Jayavsingh30/Rubiks-Cube-Solving-Robot-/README.md

https://github.com/user-attachments/assets/8eff1edc-73fc-4dad-ae04-fb5bdb494c74
