Jayavsingh30/Rubiks-Cube-Solving-Robot-/Hardware/pcb/arduino_nano/abc.kicad_pcb

## KiCad design Hardware/pcb/arduino_nano/abc.kicad_pcb (2025-05-24)

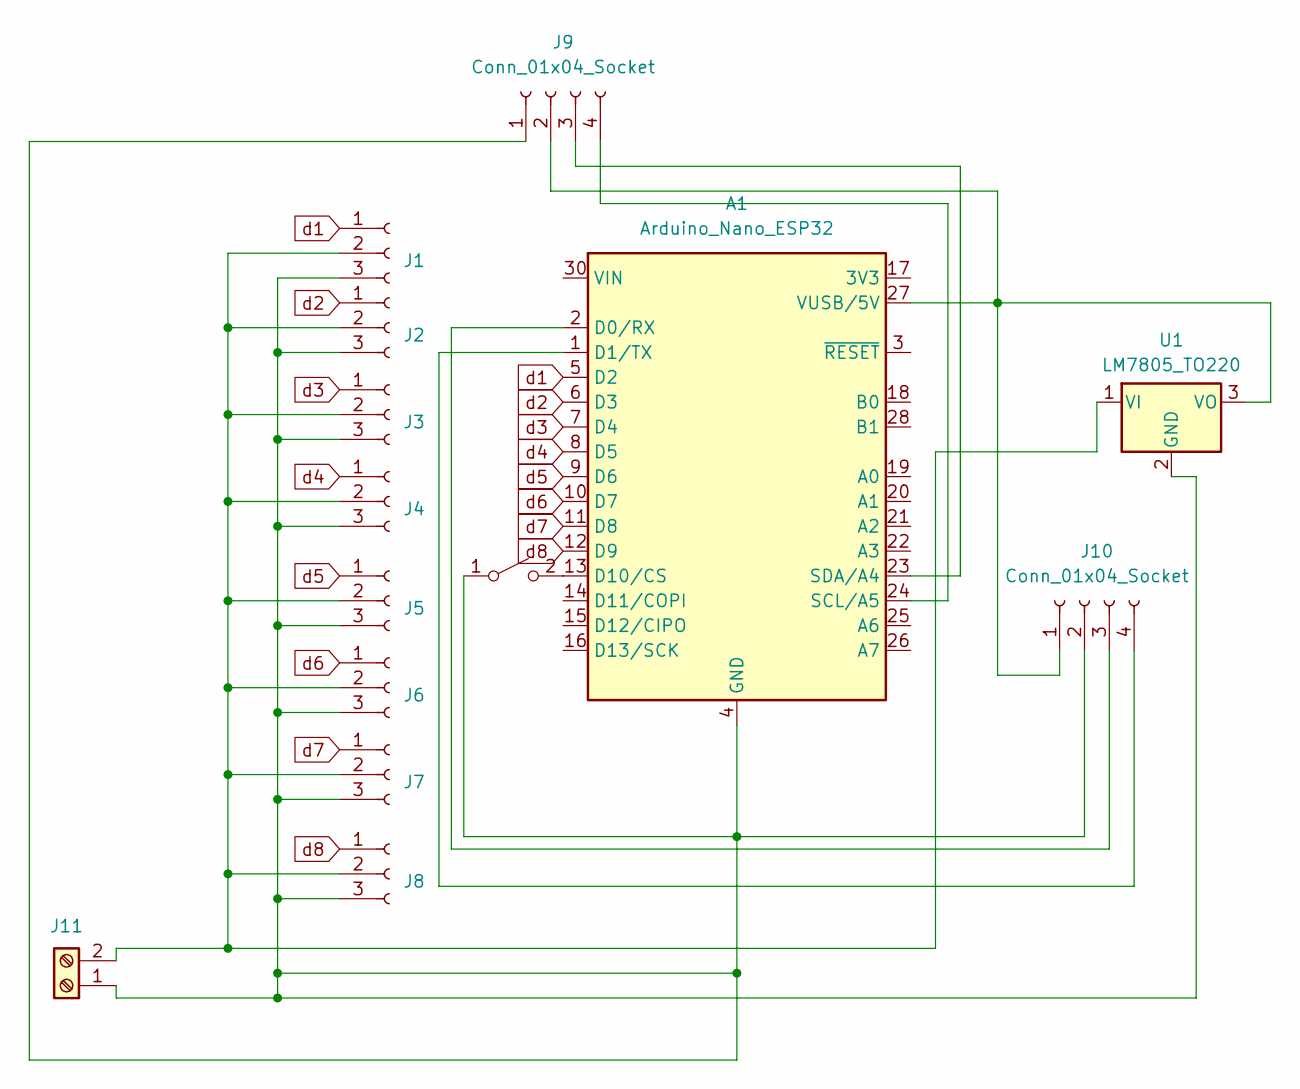
[picture p16: schematic abc.kicad_sch]

Parts:
A1: Arduino_Nano_ESP32; Arduino_Nano
J1, J2, J3, J4, J5, J6, J7, J8: Conn_01x03_Socket; PinHeader_1x03_P2.54mm_Vertical
J9, J10: Conn_01x04_Socket; PinHeader_1x04_P2.54mm_Vertical
J11: Screw_Terminal_01x02; TerminalBlock_Phoenix_MKDS-1,5-2-5.08_1x02_P5.08mm_Horizont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
SW1: SW_SPST; SW_PUSH_6mm_H4.3mm
U1: LM7805_TO220; TO-220-3_Vertical

Connections:
unnamed: A1.2 (D0/RX), J10.3
unnamed: A1.1 (D1/TX), J10.4
unnamed: A1.13 (D10/CS), SW1.2 (B)
unnamed: A1.24 (SCL/A5), J9.4
unnamed: A1.23 (SDA/A4), J9.3
unnamed: A1.27 (VUSB/5V), J9.2, J10.1, U1.3 (VO)
unnamed: J1.2, J2.2, J3.2, J4.2, J5.2, J6.2, J7.2, J8.2, J11.2, U1.1 (VI)
unnamed: A1.4 (GND), A1.29 (GND), J1.3, J2.3, J3.3, J4.3, J5.3, J6.3, J7.3, J8.3, J9.1, J10.2, J11.1, SW1.1 (A), U1.2 (GND)
d1: A1.5 (D2), J1.1
d2: A1.6 (D3), J2.1
d3: A1.7 (D4), J3.1
d4: A1.8 (D5), J4.1
d5: A1.9 (D6), J5.1
d6: A1.10 (D7), J6.1
d7: A1.11 (D8), J7.1
d8: A1.12 (D9), J8.1

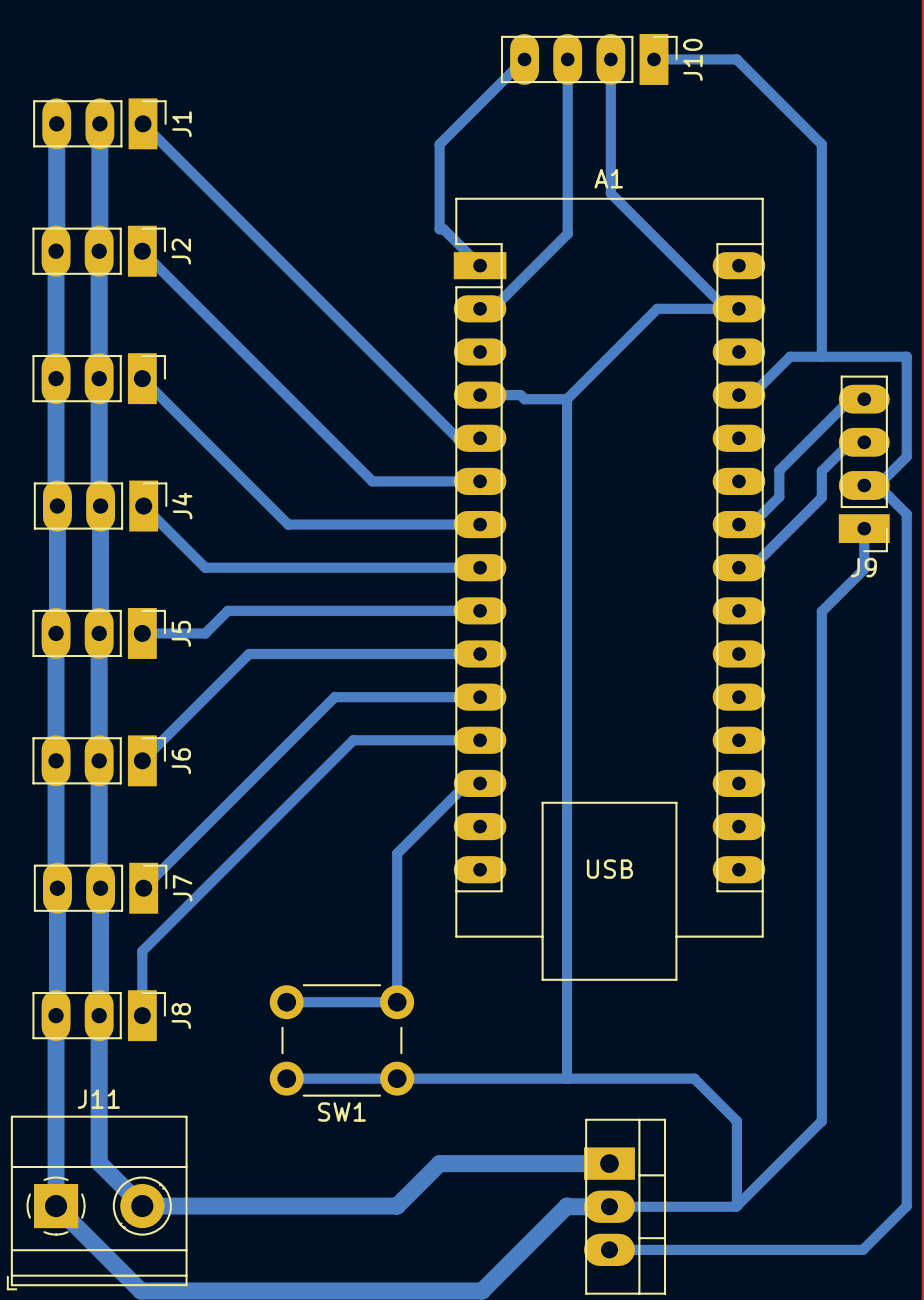
[picture p17: board abc.kicad_pcb from above]

Board: 2 copper layers, 14 parts (0 on the bottom side), 16 nets.
