Jayavsingh30/Rubiks-Cube-Solving-Robot-/Hardware/pcb/bare_ic/rubiks_cube_esp12e.kicad_pcb

## KiCad design Hardware/pcb/bare_ic/rubiks_cube_esp12e.kicad_pcb (2025-05-24)

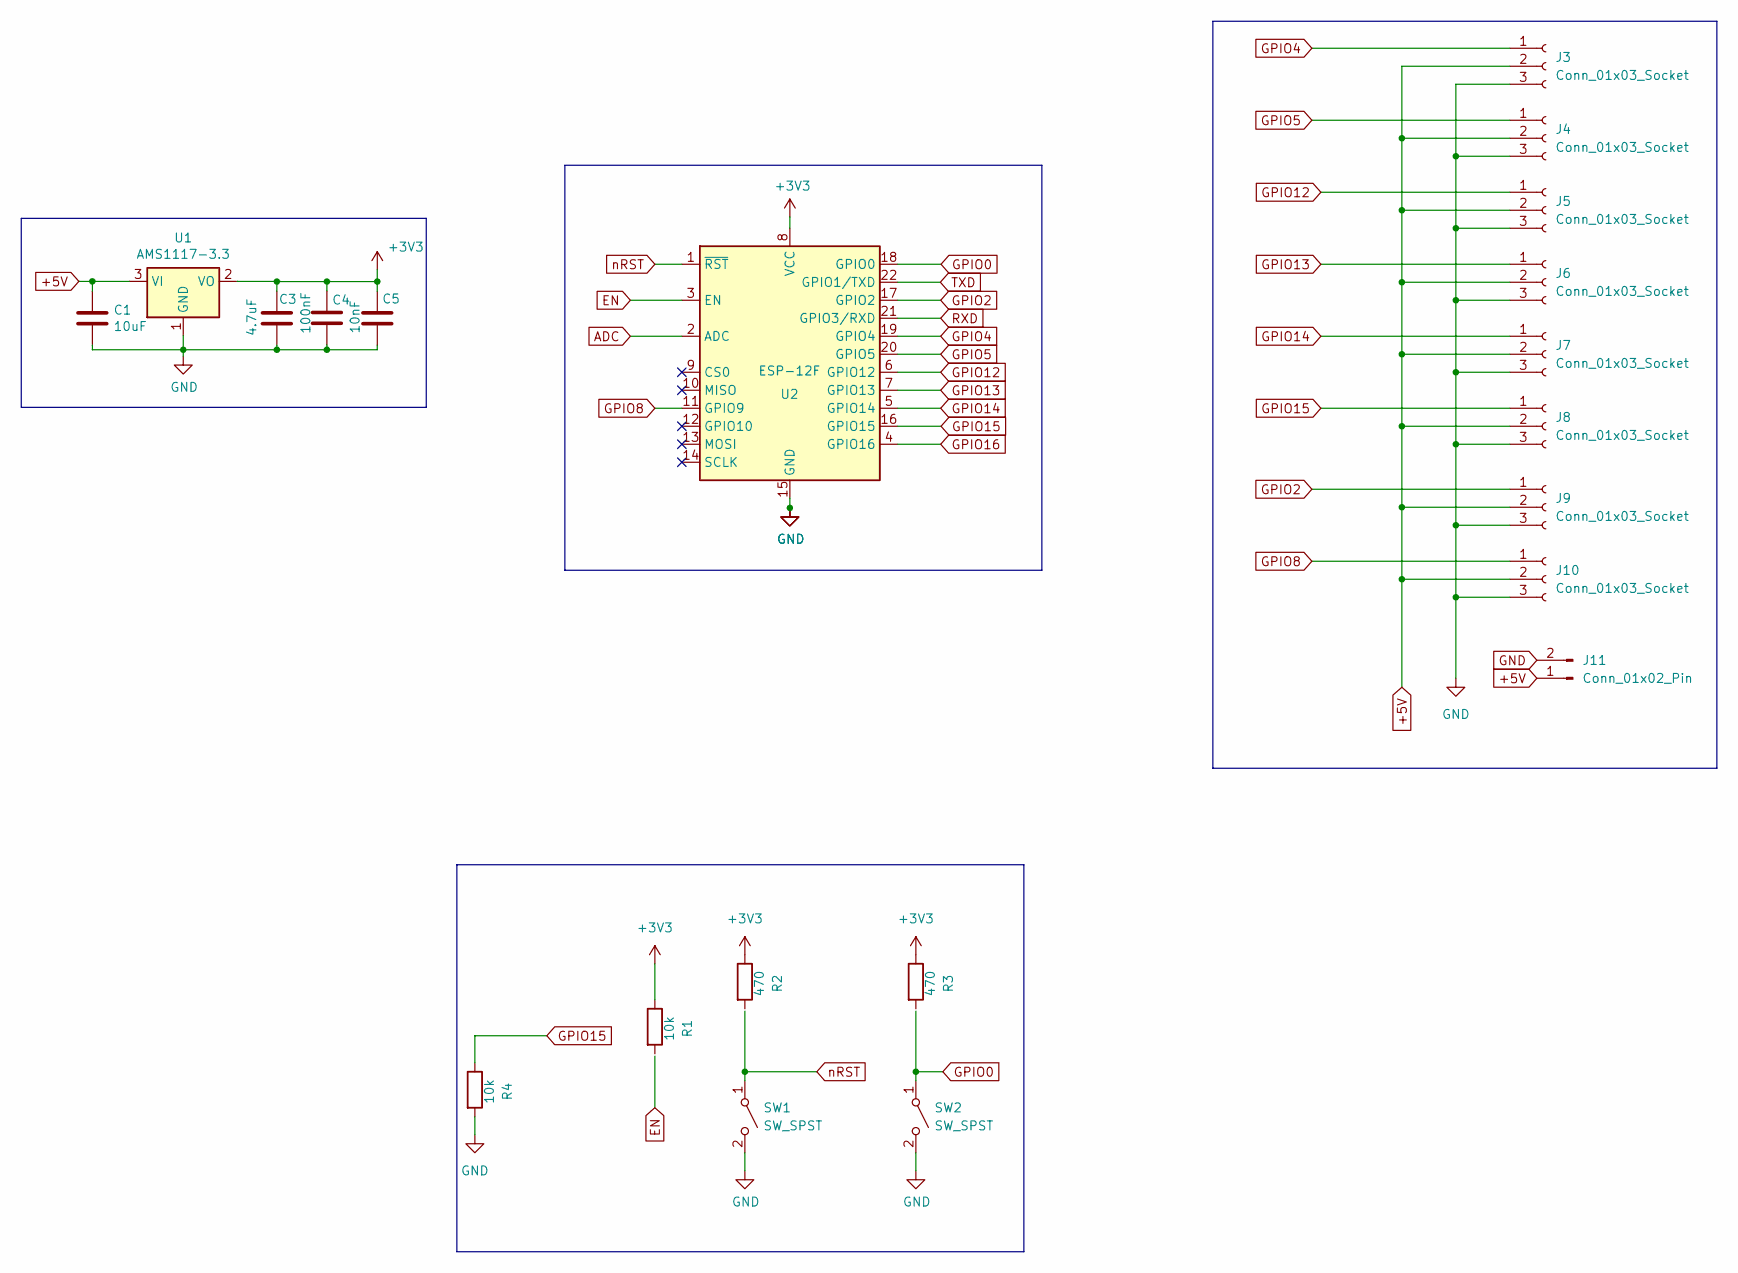
[picture p18: schematic rubiks_cube_esp12e.kicad_sch, ESP8266 Dev Board]

Parts:
C1: 10uF; C_0805_2012Metric_Pad1.18x1.45mm_HandSolder
C3: 4.7uF; C_0805_2012Metric_Pad1.18x1.45mm_HandSolder
C4: 100nF; C_0805_2012Metric_Pad1.18x1.45mm_HandSolder
C5: 10nF; C_0805_2012Metric_Pad1.18x1.45mm_HandSolder
J3, J4, J5, J6, J7, J8, J9, J10: Conn_01x03_Socket; PinHeader_1x03_P2.54mm_Vertical
J11: Conn_01x02_Pin; TerminalBlock_Phoenix_MKDS-1,5-2-5.08_1x02_P5.08mm_Horizont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
R1, R4: 10k; R_0805_2012Metric
R2, R3: 470; R_0805_2012Metric
SW1, SW2: SW_SPST; SW_PUSH_6mm_H5mm
U1: AMS1117-3.3; SOT-223-3_TabPin2
U2: ESP-12F; ESP-12E

Connections:
+3V3: C3.1, C4.1, C5.1, R1.1, R2.1, R3.1, U1.2 (VO), U2.8 (VCC)
+5V: C1.1, J3.2, J4.2, J5.2, J6.2, J7.2, J8.2, J9.2, J10.2, J11.1, U1.3 (VI)
ADC: U2.2 (ADC)
EN: U2.3 (EN)
GND: C1.2, C3.2, C4.2, C5.2, J3.3, J4.3, J5.3, J6.3, J7.3, J8.3, J9.3, J10.3, J11.2, R4.2, SW1.2 (B), SW2.2 (B), U1.1 (GND), U2.15 (GND)
GPIO0: SW2.1 (A), U2.18 (GPIO0)
GPIO2: J9.1, U2.17 (GPIO2)
GPIO4: J3.1, U2.19 (GPIO4)
GPIO5: J4.1, U2.20 (GPIO5)
GPIO8: J10.1, U2.11 (GPIO9)
GPIO12: J5.1, U2.6 (GPIO12)
GPIO13: J6.1, U2.7 (GPIO13)
GPIO14: J7.1, U2.5 (GPIO14)
GPIO15: J8.1, R4.1, U2.16 (GPIO15)
GPIO16: U2.4 (GPIO16)
RXD: U2.21 (GPIO3/RXD)
TXD: U2.22 (GPIO1/TXD)
nRST: SW1.1 (A), U2.1 (~RST)

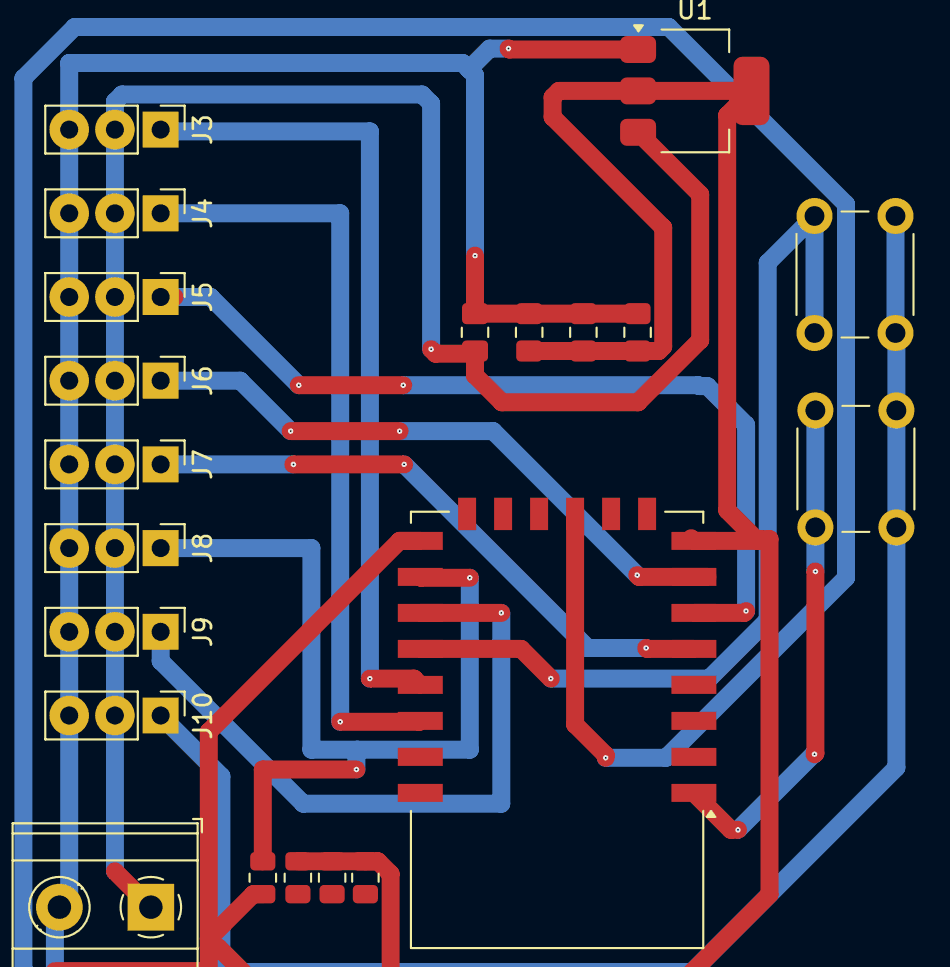
[picture p19: board rubiks_cube_esp12e.kicad_pcb from above]

Board: 2 copper layers, 21 parts (0 on the bottom side), 13 nets.
